SOFTCARCLEAN/SoftcarREX/Documents/Datasheets/Détendeur/Manuel page 2.jpg

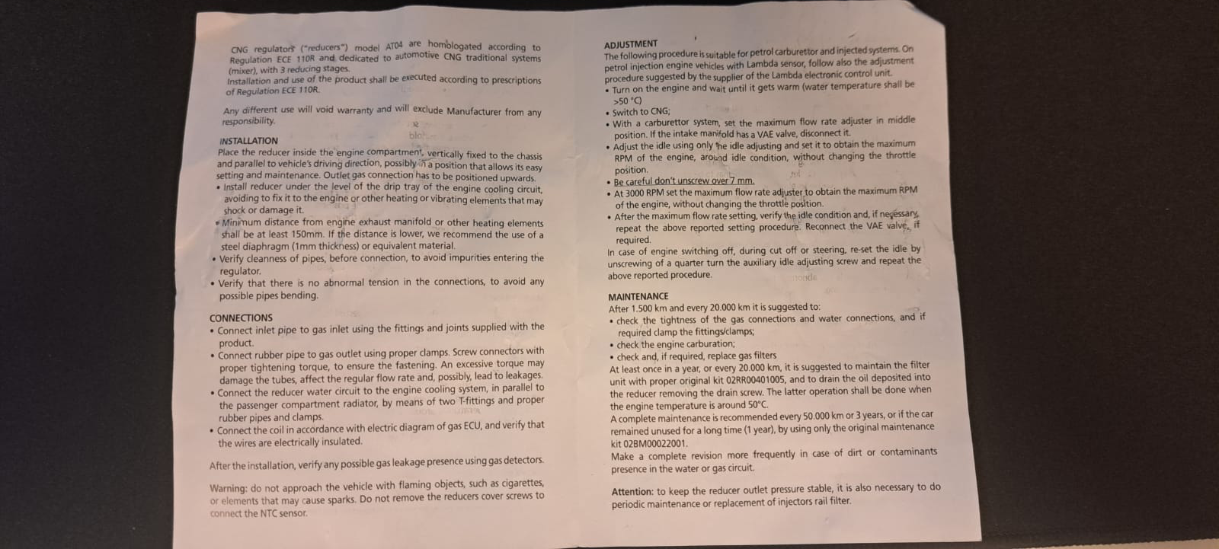
Documents/Datasheets/Détendeur/Manuel page 2.jpg
