SOFTCARCLEAN/SoftcarREX/Documents/Datasheets/Détendeur/Manuel page 3.jpg

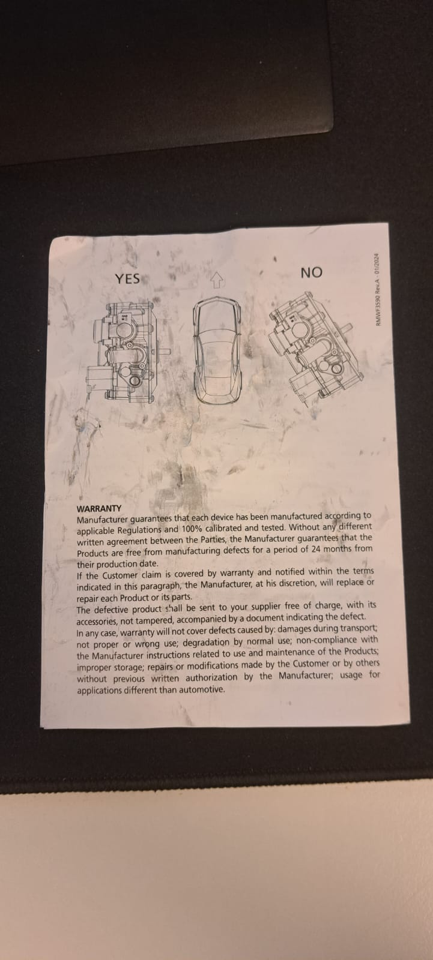
Documents/Datasheets/Détendeur/Manuel page 3.jpg
