SOFTCARCLEAN/SoftcarREX/Documents/Datasheets/Détendeur/Manuel page 1.jpg

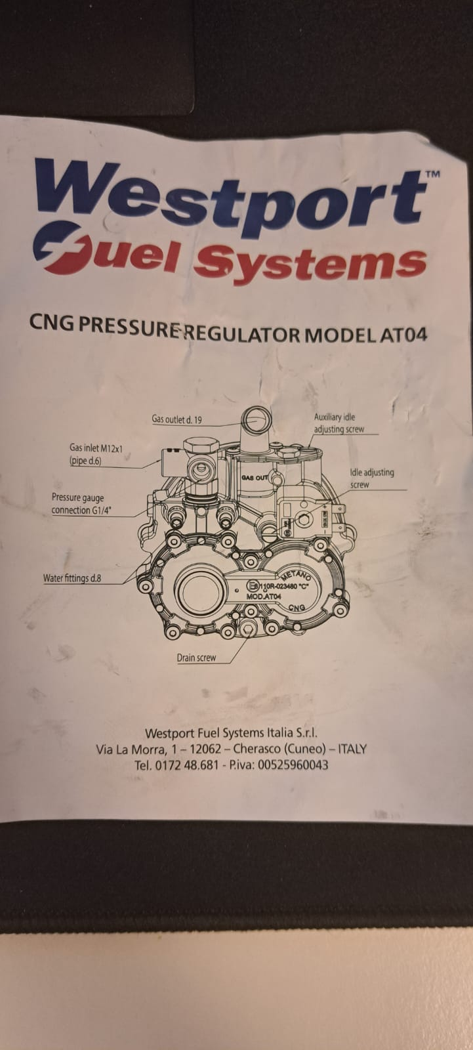
Documents/Datasheets/Détendeur/Manuel page 1.jpg
