SOFTCARCLEAN/SoftcarREX/Documents/Datasheets/Détendeur/Reducer.png

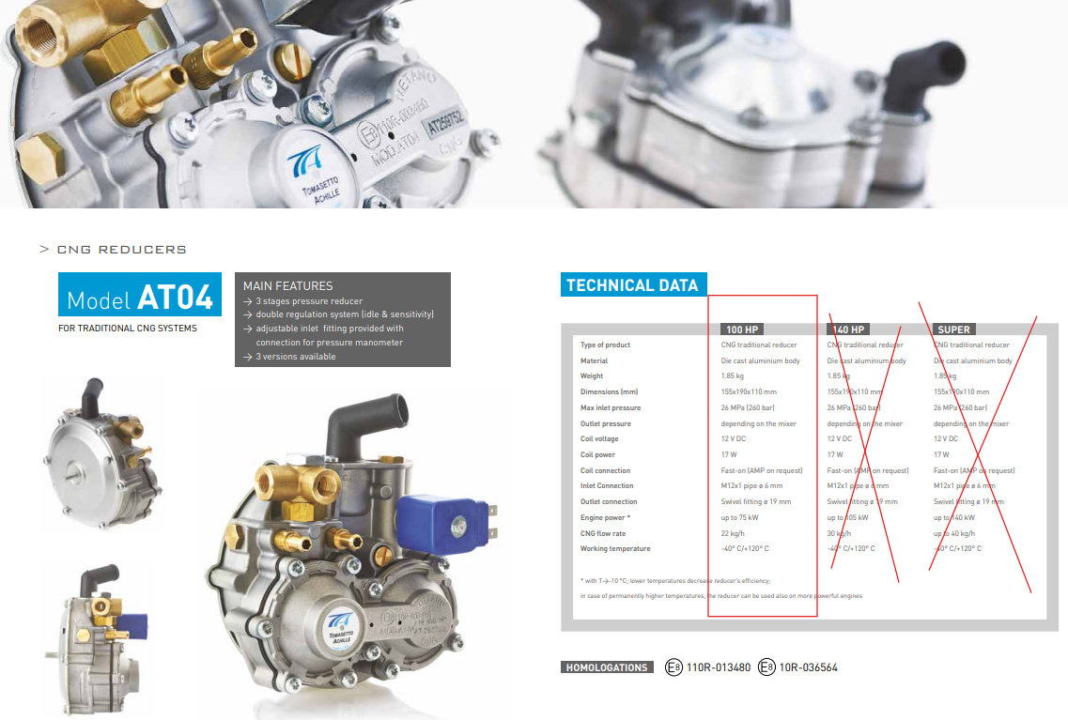
Documents/Datasheets/Détendeur/Reducer.png
