SOFTCARCLEAN/SoftcarREX/Documents/Labels.xlsx

Sheet: CRMT
 | Banc REX
Color | Label | From component | From connector | Pin | Supplier | Supplier PN | To component | To connector | Pin | Supplier | Supplier PN
 | Pilotage relais ventilation | Engine Controller Unit (ECU) | CN1 | A3 | MOLEX | 64 319 - 1218 64 319 - 1201 64 322 - 1029 64 323 - 1029 | Relais ventilation et DC-DC | CN7 | 1 | DEUTSCH | DTM 06-25 0462 2012 0141 WM2P
 | Pilotage relais DC-DC | Engine Controller Unit (ECU) | CN1 | B2 | MOLEX | 64 319 - 1218 64 319 - 1201 64 322 - 1029 64 323 - 1029 | Relais ventilation et DC-DC | CN7 | 2 | DEUTSCH | DTM 06-25 0462 2012 0141 WM2P
 | Commande injecteur | Engine Controller Unit (ECU) | CN1 | E4 | MOLEX | 64 319 - 1218 64 319 - 1201 64 322 - 1029 64 323 - 1029 | Injecteur | CN5 | 2 | PRINS | 180/000024/A
 | Commande bobine | Engine Controller Unit (ECU) | CN1 | F3 | MOLEX | 64 319 - 1218 64 319 - 1201 64 322 - 1029 64 323 - 1029 | Bobine | CN6 | 3 | METRI-PACK | 12162834 12089290-4
 | Signal capteur régime moteur | Engine Controller Unit (ECU) | CN2 | A1 | MOLEX | 64 320 - 1319 64 320 - 1301 64 322 - 1029 64 323 - 1029 | Capteur régime moteur | CN9 | 1 | BOSCH | 1 928 402 110 1 987 280 103 1 987 280 106
 | Papillon signal position 1B | Engine Controller Unit (ECU) | CN2 | A3 | MOLEX | 64 320 - 1319 64 320 - 1301 64 322 - 1029 64 323 - 1029 | Moteur papillon | CN8 | 5 | BOSCH | 1 096 7360 1 0 096 5906 5 0 096 7067 1
 | Papillon signal position 1A | Engine Controller Unit (ECU) | CN2 | A4 | MOLEX | 66 320 - 1319 64 320 -1301 64 322 - 1029 64 323 - 1029 | Moteur papillon | CN8 | 6 | BOSCH | 1 096 7360 1 0 096 5906 5 0 096 7067 1
 | Signal pression rail injecteur | Engine Controller Unit (ECU) | CN2 | B1 | MOLEX | 64 320 - 1319 64 320 - 1301 64 322 - 1029 64 323 - 1029 | Capteur pression/température gaz | CN11 | 4 | BOSCH | 1 928 403 736 1 987 280 103 1 987 280 106
 | Signal collecteur admission | Engine Controller Unit (ECU) | CN2 | D2 | MOLEX | 64 320 - 1319 64 320 - 1301 64 322 - 1029 64 323 - 1029 | Capteur pression/température air | CN12 | 4 | BOSCH | 1 928 403 736 1 987 280 103 1 987 280 106
 | AGND capteur pression collecteur admission | Engine Controller Unit (ECU) | CN2 | D4 | MOLEX | 64 320 - 1319 64 320 - 1301 64 322 - 1029 64 323 - 1029 | Capteur pression/température air | CN12 | 1 | BOSCH | 1 928 403 736 1 987 280 103 1 987 280 106
 | Signal température rail injection | Engine Controller Unit (ECU) | CN2 | E1 | MOLEX | 64 320 - 1319 64 320 - 1301 64 322 - 1029 64 323 - 1029 | Capteur pression/température gaz | CN11 | 2 | BOSCH | 1 928 403 736 1 987 280 103 1 987 280 106
 | Signal température collecteur admission | Engine Controller Unit (ECU) | CN2 | E2 | MOLEX | 64 320 - 1319 64 320 - 1301 64 322 - 1029 64 323 - 1029 | Capteur pression/température air | CN12 | 2 | BOSCH | 1 928 403 736 1 987 280 103 1 987 280 106
 | Signal température eau | Engine Controller Unit (ECU) | CN2 | F1 | MOLEX | 64 320 - 1319 64 320 - 1301 64 322 - 1029 64 323 - 1029 | Capteur température eau | CN10 | 1 | JPT | 0-0282189-1 0-0929940-3 0-0828905-1
 | Signal température échappement | Engine Controller Unit (ECU) | CN2 | F2 | MOLEX | 64 320 - 1319 64 320 - 1301 64 322 - 1029 64 323 - 1029 | Capteur température échappement | CN13 | 1 | DEUTSCH | DTM0625 046220120141 WM25
 | AGND température échappement | Engine Controller Unit (ECU) | CN2 | F3 | MOLEX | 64 320 - 1319 64 320 - 1301 64 322 - 1029 64 323 - 1029 | Capteur température échappement | CN13 | 2 | DEUTSCH | DTM0625 046220120141 WM25
 | AGND capteur rail injection | Engine Controller Unit (ECU) | CN2 | F4 | MOLEX | 64 320 - 1319 64 320 - 1301 64 322 - 1029 64 323 - 1029 | Capteur pression/température gaz | CN11 | 1 | BOSCH | 1 928 403 736 1 987 280 103 1 987 280 106
 | AGND papillon | Engine Controller Unit (ECU) | CN2 | G3 | MOLEX | 64 320 - 1319 64 320 - 1301 64 322 - 1029 64 323 - 1029 | Moteur papillon | CN8 | 2 | BOSCH | 1 096 7360 1 0 096 5906 5 0 096 7067 1
 | AGND température eau | Engine Controller Unit (ECU) | CN2 | G4 | MOLEX | 64 320 - 1319 64 320 - 1301 64 322 - 1029 64 323 - 1029 | Capteur température eau | CN10 | 2 | JPT | 0-0282189-1 0-0929940-3 0-0828905-1
 | AGND lambda HEGO ON/OFF | Engine Controller Unit (ECU) | CN2 | H3 | MOLEX | 64 320 - 1319 64 320 - 1301 64 322 - 1029 64 323 - 1029 | Sonde lambda HEGO | CN14 | 3 | BOSCH | 1 928 403 736 1 987 280 103 1 987 280 106
 | Lambda UEGO RCOMP | Engine Controller Unit (ECU) | CN2 | J1 | MOLEX | 64 320 - 1319 64 320 - 1301 64 322 - 1029 64 323 - 1029 | Sonde lambda UEGO | CN15 | 4 | VW | 1J0973733 0-0929940-3 0-0829904-1
 | Lambda UEGO VSIP | Engine Controller Unit (ECU) | CN2 | J2 | MOLEX | 64 320 - 1319 64 320 - 1301 64 322 - 1029 64 323 - 1029 | Sonde lambda UEGO | CN15 | 6 | VW | 1J0973733 0-0929940-3 0-0829904-1
 | AGND capteur régime moteur | Engine Controller Unit (ECU) | CN2 | J4 | MOLEX | 64 320 - 1319 64 320 - 1301 64 322 - 1029 64 323 - 1029 | Capteur régime moteur | CN9 | 2 | BOSCH | 1 928 402 110 1 987 280 103 1 987 280 106
 | Lambda UEGO VS | Engine Controller Unit (ECU) | CN2 | K1 | MOLEX | 64 320 - 1319 64 320 - 1301 64 322 - 1029 64 323 - 1029 | Sonde lambda UEGO | CN15 | 5 | VW | 1J0973733 0-0929940-3 0-0829904-1
 | Lambda UEGO IP | Engine Controller Unit (ECU) | CN2 | K2 | MOLEX | 64 320 - 1319 64 320 - 1301 64 322 - 1029 64 323 - 1029 | Sonde lambda UEGO | CN15 | 3 | VW | 1J0973733 0-0929940-3 0-0829904-1
 | Lambda HEGO ON/OFF | Engine Controller Unit (ECU) | CN2 | K3 | MOLEX | 64 320 - 1319 64 320 - 1301 64 322 - 1029 64 323 - 1029 | Sonde lambda HEGO | CN14 | 4 | BOSCH | 1 928 403 736 1 987 280 103 1 987 280 106
 | VREF capteur rail injection | Engine Controller Unit (ECU) | CN2 | K4 | MOLEX | 64 320 - 1319 64 320 - 1301 64 322 - 1029 64 323 - 1029 | Capteur pression/température gaz | CN11 | 3 | BOSCH | 1 928 403 736 1 987 280 103 1 987 280 106
 | VREF papillon | Engine Controller Unit (ECU) | CN2 | L1 | MOLEX | 64 320 - 1319 64 320 - 1301 64 322 - 1029 64 323 - 1029 | Moteur papillon | CN8 | 3 | BOSCH | 1 096 7360 1 0 096 5906 5 0 096 7067 1
 | VREF capteur pression collecteur admission | Engine Controller Unit (ECU) | CN2 | L3 | MOLEX | 64 320 - 1319 64 320 - 1301 64 322 - 1029 64 323 - 1029 | Capteur pression/température air | CN12 | 3 | BOSCH | 1 928 403 736 1 987 280 103 1 987 280 106
 | Moteur papillon (-) | Engine Controller Unit (ECU) | CN2 | M1 | MOLEX | 64 320 - 1319 64 320 - 1301 64 322 - 1029 64 323 - 1029 | Moteur papillon | CN8 | 1 | BOSCH | 1 096 7360 1 0 096 5906 5 0 096 7067 1
 | Moteur papillon (+) | Engine Controller Unit (ECU) | CN2 | M2 | MOLEX | 64 320 - 1319 64 320 - 1301 64 322 - 1029 64 323 - 1029 | Moteur papillon | CN8 | 4 | BOSCH | 1 096 7360 1 0 096 5906 5 0 096 7067 1
 | Lambda HEGO Chauffe | Engine Controller Unit (ECU) | CN2 | M3 | MOLEX | 64 320 - 1319 64 320 - 1301 64 322 - 1029 64 323 - 1029 | Sonde lambda HEGO | CN14 | 1 | BOSCH | 1 928 403 736 1 987 280 103 1 987 280 106
 | Lambda UEGO Chauffe | Engine Controller Unit (ECU) | CN2 | M4 | MOLEX | 64 320 - 1319 64 320 - 1301 64 322 - 1029 64 323 - 1029 | Sonde lambda UEGO | CN15 | 1 | VW | 1J0973733 0-0929940-3 0-0829904-1
 | Contact | Engine Controller Unit (ECU) | CN3 | C4 | MOLEX | 64 320 - 1311 64 320 - 1301 64 322 - 1029 64 323 - 1029
 | Commande relais principal | Engine Controller Unit (ECU) | CN3 | H2 | MOLEX | 64 320 - 1311 64 320 - 1301 64 322 - 1029 64 323 - 1029 | Relais principal | CN4 | 2 | BOSCH | 3 334 485 008 0 558 60 320 0 558 99 62
 | CAN-1 L | Engine Controller Unit (ECU) | CN3 | J1 | MOLEX | 64 320 - 1311 64 320 - 1301 64 322 - 1029 64 323 - 1029 | CAN 1 | CN18 | 2 | SUB-D9
 | CAN-1 H | Engine Controller Unit (ECU) | CN3 | J2 | MOLEX | 64 320 - 1311 64 320 - 1301 64 322 - 1029 64 323 - 1029 | CAN 1 | CN18 | 7 | SUB-D9
 | CAN-2 L | Engine Controller Unit (ECU) | CN3 | J3 | MOLEX | 64 320 - 1311 64 320 - 1301 64 322 - 1029 64 323 - 1029 | Sonde NOX | CN16 | 3 | MCOM | 1-1718806-1 7-1452668-1 7-1452671-1
 | CAN-2 H | Engine Controller Unit (ECU) | CN3 | J4 | MOLEX | 64 320 - 1311 64 320 - 1301 64 322 - 1029 64 323 - 1029 | Sonde NOX | CN16 | 4 | MCOM | 1-1718806-1 7-1452668-1 7-1452671-1
 | CAN-2 L | Engine Controller Unit (ECU) | CN3 | J3 | MOLEX | 64 320 - 1311 64 320 - 1301 64 322 - 1029 64 323 - 1029 | CAN 2 | CN17 | 2 | SUB-D9
 | CAN-2 H | Engine Controller Unit (ECU) | CN3 | J4 | MOLEX | 64 320 - 1311 64 320 - 1301 64 322 - 1029 64 323 - 1029 | CAN 2 | CN17 | 7 | SUB-D9
 | GND | Engine Controller Unit (ECU) | CN3 | L1 | MOLEX | 64 320 - 1311 64 320 - 1301 64 322 - 1029 64 323 - 1029
 | GND | Engine Controller Unit (ECU) | CN3 | L2 | MOLEX | 64 320 - 1311 64 320 - 1301 64 322 - 1029 64 323 - 1029
 | GND | Engine Controller Unit (ECU) | CN3 | L3 | MOLEX | 64 320 - 1311 64 320 - 1301 64 322 - 1029 64 323 - 1029
 | GND | Engine Controller Unit (ECU) | CN3 | L4 | MOLEX | 64 320 - 1311 64 320 - 1301 64 322 - 1029 64 323 - 1029
 | GND | Sonde NOX | CN16 | 2 | MCOM | 1-1718806-1 7-1452668-1 7-1452671-1
 | GND | Bobine | CN6 | 1 | METRI-PACK | 12162834 12089290-4
 | GND | Bobine | CN6 | 2 | METRI-PACK | 12162834 12089290-4
 | 12V commuté | Relais principal | CN4 | 4 | BOSCH | 3 334 485 008 0 558 60 320 0 558 99 62 | Engine Controller Unit (ECU) | CN3 | M1 | MOLEX | 64 320 - 1311 64 320 - 1301 64 322 - 1029 64 323 - 1029
 | 12V commuté | Relais principal | CN4 | 4 | BOSCH | 3 334 485 008 0 558 60 320 0 558 99 62 | Engine Controller Unit (ECU) | CN3 | M2 | MOLEX | 64 320 - 1311 64 320 - 1301 64 322 - 1029 64 323 - 1029
 | 12V commuté | Relais principal | CN4 | 4 | BOSCH | 3 334 485 008 0 558 60 320 0 558 99 62 | Engine Controller Unit (ECU) | CN3 | M3 | MOLEX | 64 320 - 1311 64 320 - 1301 64 322 - 1029 64 323 - 1029
 | 12V commuté | Relais principal | CN4 | 4 | BOSCH | 3 334 485 008 0 558 60 320 0 558 99 62 | Engine Controller Unit (ECU) | CN3 | M4 | MOLEX | 64 320 - 1311 64 320 - 1301 64 322 - 1029 64 323 - 1029
 | 12V commuté | Relais principal | CN4 | 4 | BOSCH | 3 334 485 008 0 558 60 320 0 558 99 62 | Injecteur | CN5 | 1 | PRINS | 180/000024/A
 | 12V commuté | Relais principal | CN4 | 4 | BOSCH | 3 334 485 008 0 558 60 320 0 558 99 62 | Bobine | CN6 | 4 | METRI-PACK | 12162834 12089290-4
 | 12V commuté | Relais principal | CN4 | 4 | BOSCH | 3 334 485 008 0 558 60 320 0 558 99 62 | Sonde lambda HEGO | CN14 | 2 | BOSCH | 1 928 403 736 1 987 280 103 1 987 280 106
 | 12V commuté | Relais principal | CN4 | 4 | BOSCH | 3 334 485 008 0 558 60 320 0 558 99 62 | Sonde lambda UEGO | CN15 | 2 | VW | 1J0973733 0-0929940-3 0-0829904-1
 | 12V commuté | Relais principal | CN4 | 4 | BOSCH | 3 334 485 008 0 558 60 320 0 558 99 62 | Sonde NOX | CN16 | 1 | MCOM | 1-1718806-1 7-1452668-1 7-1452671-1
 | 12V constant | Relais principal | CN4 | 1 | BOSCH | 3 334 485 008 0 558 60 320 0 558 99 62 | Relais principal | CN4 | 3 | BOSCH | 3 334 485 008 0 558 60 320 0 558 99 62

Sheet: REX Chinois
 | Banc REX
Color | Label | From component | From connector | Pin | Supplier | Supplier PN | To component | To connector | Pin | Supplier | Supplier PN
 | Power switch START "I" | REX Chinois | CN19 | 2 | JST | XAP-04V-1 SXA-001T-P0.6 | Switch start/stop (control panel) | Presse-etoupe | I | / | FastON
 | Power switch FLAMEOUT "II" | REX Chinois | CN19 | 3 | JST | XAP-04V-1 SXA-001T-P0.6 | Switch start/stop (control panel) | Presse-etoupe | II | / | FastON
 | Power swtich commun | REX Chinois | CN19 | 4 | JST | XAP-04V-1 SXA-001T-P0.6 | Switch start/stop (control panel) | Presse-etoupe | COM | / | FastON
 | Led indicator 1 | REX Chinois | CN20 | 1 | JST | XAP-06V-1 SXA-001T-P0.6 | Led indicator (control panel) | Presse-etoupe | ? | / | Solder
 | Led indicator 2 | REX Chinois | CN20 | 2 | JST | XAP-06V-1 SXA-001T-P0.6 | Led indicator (control panel) | Presse-etoupe | ? | / | Solder
 | Led indicator 3 | REX Chinois | CN20 | 3 | JST | XAP-06V-1 SXA-001T-P0.6 | Led indicator (control panel) | Presse-etoupe | ? | / | Solder
 | Generator enable 1 | REX Chinois | CN25 | / | / | Screw | Generator enable switch (control panel) | Presse-etoupe | 1 | / | FastON
 | Generator enable 2 | REX Chinois | CN30 | / | / | FastON | Generator enable switch (control panel) | Presse-etoupe | 2 | / | FastON
 |  | REX Chinois | CN22 | 1 | JST | XAP-05V-1 SXA-001T-P0.6 | Moteur papillon | / | 1 | JST | B5B-XH-A
 |  | REX Chinois | CN22 | 2 | JST | XAP-05V-1 SXA-001T-P0.7 | Moteur papillon | / | 2 | JST | B5B-XH-A
 |  | REX Chinois | CN22 | 3 | JST | XAP-05V-1 SXA-001T-P0.8 | Moteur papillon | / | 3 | JST | B5B-XH-A
 |  | REX Chinois | CN22 | 4 | JST | XAP-05V-1 SXA-001T-P0.9 | Moteur papillon | / | 4 | JST | B5B-XH-A
 |  | REX Chinois | CN22 | 5 | JST | XAP-05V-1 SXA-001T-P0.10 | Moteur papillon | / | 5 | JST | B5B-XH-A
 | Bougie 1 | REX Chinois | CN23 | 1 | JST | XAP-02V-1 SXA-001T-P0.6 | Wago+ (control panel) | Presse-etoupe | / | / | Solder
 | Bougie 2 | REX Chinois | CN23 | 2 | JST | XAP-02V-1 SXA-001T-P0.6 | Driver bougie chinois | / | / | / | Solder
 | 144V (+) | REX Chinois | CN25 | / | / | Screw | Contacteur (control panel)
 | 144V (-) | REX Chinois | CN26 | / | / | Screw
 |  | REX Chinois
 |  | REX Chinois
 |  | REX Chinois
 |  | REX Chinois
 |  | REX Chinois
 |  | REX Chinois
 |  | REX Chinois
 |  | REX Chinois
 |  | REX Chinois
 |  | REX Chinois
 |  | REX Chinois
 |  | REX Chinois
 |  | REX Chinois
 |  | REX Chinois
 |  | REX Chinois
 |  | REX Chinois
 |  | REX Chinois
 |  | REX Chinois
 |  | REX Chinois
 |  | REX Chinois
 |  | REX Chinois
 |  | REX Chinois
 |  | REX Chinois
 |  | REX Chinois
 |  | REX Chinois
 |  | REX Chinois
 |  | REX Chinois
 |  | REX Chinois
 |  | REX Chinois
 |  | REX Chinois
 |  | REX Chinois
 |  | REX Chinois
 |  | REX Chinois
 |  | REX Chinois
 |  | REX Chinois
 |  | REX Chinois
 |  | REX Chinois
 |  | REX Chinois
 |  | REX Chinois
 |  | REX Chinois
 |  | REX Chinois
 |  | REX Chinois
 |  | REX Chinois
 |  | REX Chinois
 |  | REX Chinois
 |  | REX Chinois
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
