SOFTCARCLEAN/SoftcarREX/Documents/Documents partie chinoise/Schéma 144V deuxième envoi moteur.pdf

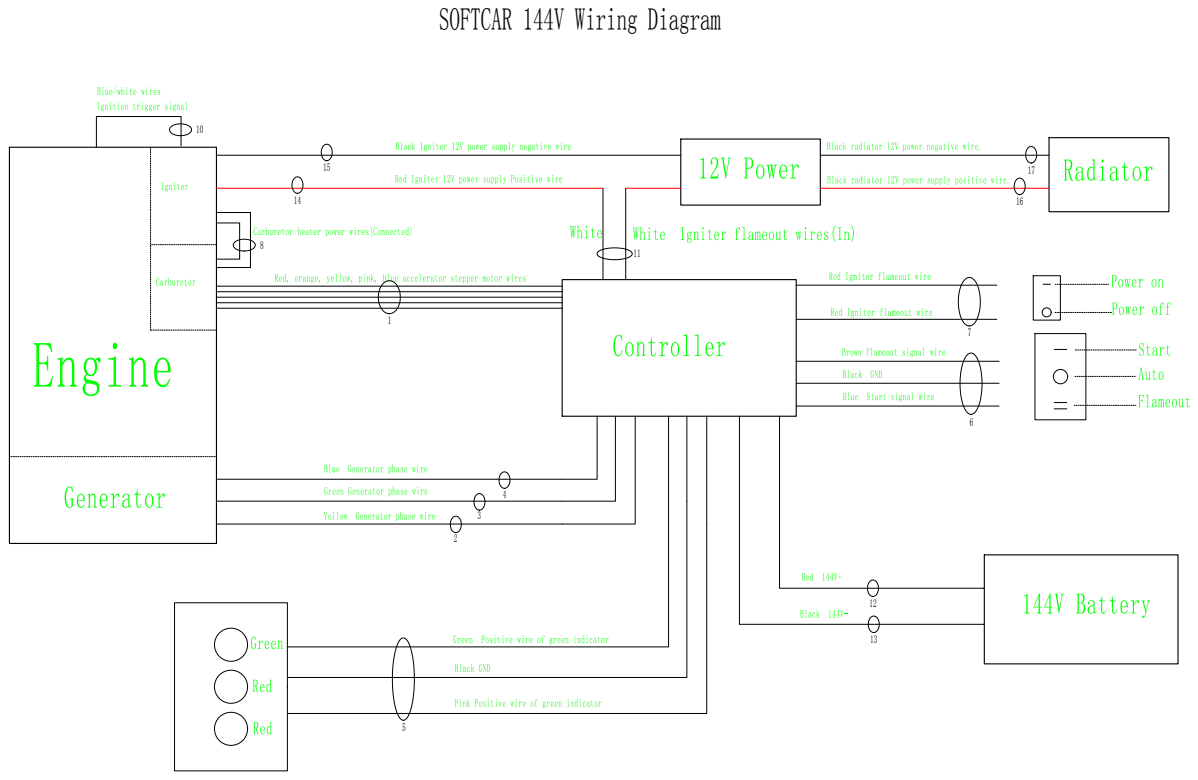
[picture p53: page 1]
12V Power; Radiator; White; White Igniter flameout wires(In); Black GND; Brown flameout signal wire; Start; Red Igniter flameout wire; Power on; Power off; Red 144V+; Black 144V-; 144V Battery

SOFTCAR 144V Wiring Diagram

Blue/white wires
Ignition trigger signal

Black Igniter 12V power supply negative wire

Black radiator 12V power negative wire.

Red Igniter 12V power supply Positive wire

Black radiator 12V power supply positive wire.

Carburetor heater power wires(Connected)

Red, orange, yellow, pink, blue accelerator stepper motor wires

Red Igniter flameout wire

Blue Start signal wire

Blue Generator phase wire

Green Generator phase wire 4

Yellow Generator phase wire 3

2 Green Positive wire of green indicator

Pink Positive wire of green indicator
