SOFTCARCLEAN/SoftcarREX/Documents/Documents partie chinoise/Schéma controleur moteur deuxième envoi moteur.pdf

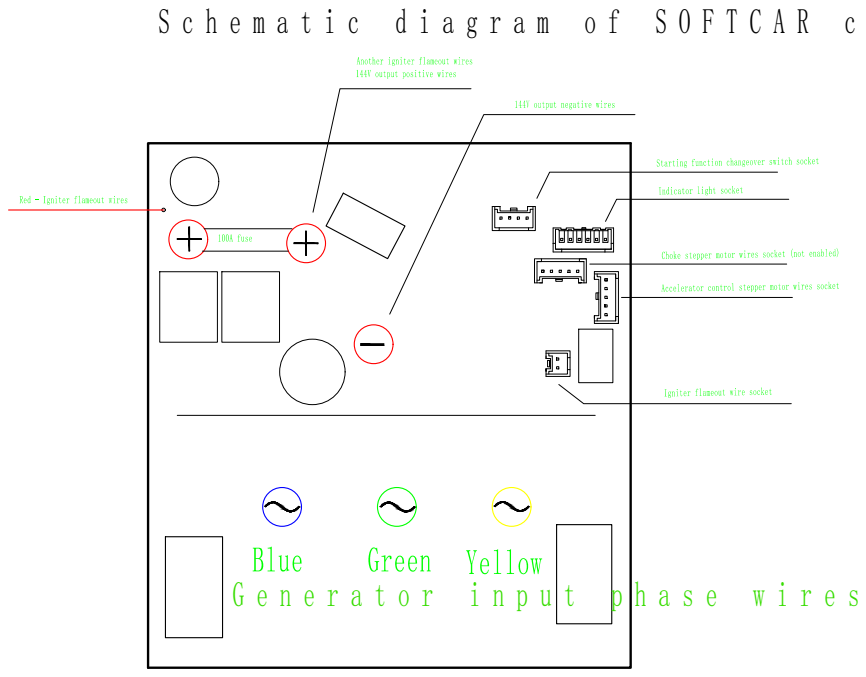
[picture p54: page 1]
100A fuse Red; - Igniter flameout wires; 144V output positive wires 144V output negative wires Blue GreenYellow; Starting function changeover switch socket Indicator light socket Choke stepper motor wires socket (not enabled) Accelerator control stepper motor wires socket Igniter flameout wire socket; Generator input; phase wires

Schematic diagram of SOFTCAR controller

Another igniter flameout wires
