SOFTCARCLEAN/SoftcarREX/(commit log)

2024-08-09 Début from to list et du schéma
    [BancREX.kicad_sch, Connecteurs.xlsx]
2024-08-12 Continuation du excel
    [Connecteurs.xlsx]
2024-08-12 Continuation du schéma
    [BancREX.kicad_sch, Labels.xlsx]
2024-08-15 Avancement schéma et excel
    [BancREX.kicad_sch, ControlPanel.kicad_sch, Labels.xlsx]
2024-09-09 Modif schéma, validé ?
    [BancREX.kicad_sch, ControlPanel.kicad_sch]
2024-09-30 Retrait valve2 détendeur
    [BancREX.kicad_sch, ControlPanel.kicad_sch]
2024-10-04 Sourcing des connecteurs
    [BancREX.kicad_sch, ControlPanel.kicad_sch, VehiculeREX.kicad_pcb, VehiculeREX.kicad_sch]
2024-10-04 Corrections schema banc et début schéma véhicule
    [BancREX.kicad_sch, VehiculeREX.kicad_sch]
2024-10-07 Corrections schema banc et continuation du schema véhicule
    [BancREX.kicad_sch, ControlPanel.kicad_sch, VehiculeREX.kicad_sch]
2024-10-09 Le cauchemar continue
    [BancREX.kicad_sch, VehiculeREX.kicad_sch]
2024-10-11 Bis repetita
    [VehiculeREX.kicad_sch]
2024-10-25 Je répare le git
    [VehiculeREX.kicad_sch]
2024-10-25 avancement schéma véhicule
    [VehiculeREX.kicad_sch]
2024-11-28 Push AOR
    [BancTest_PS1-4.kicad_pcb, BancTest_PS1-4.kicad_sch, VehiculeREX.kicad_sch]
2024-12-02 validation ?
    [BancTest_PS1-4.kicad_sch]
2025-01-10 Ajout des bloc pour futur modif pour CRMT
    [BancTest_PS1-4.kicad_sch, VehiculeREX.kicad_sch]
2025-01-22 push 220125
    [BancTest_PS1-4.kicad_sch, VehiculeREX.kicad_sch]
2025-02-26 corrections du schema du banc ps1-4
    [BancTest_PS1-4.kicad_sch]
